RobWilks/Seeed-Soil-Sense/Photos/20260323_125657.jpg

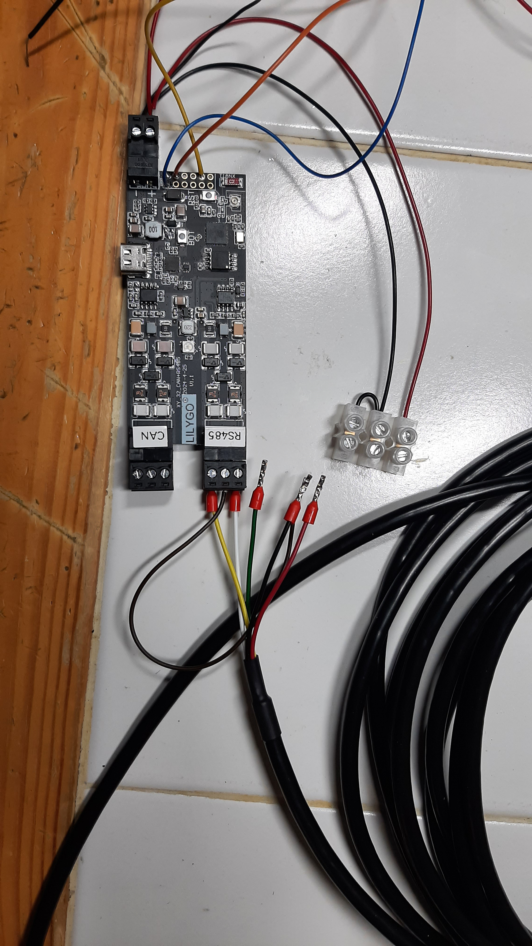
Photos/20260323_125657.jpg
