RobWilks/Seeed-Soil-Sense/Photos/20260323_132616.jpg

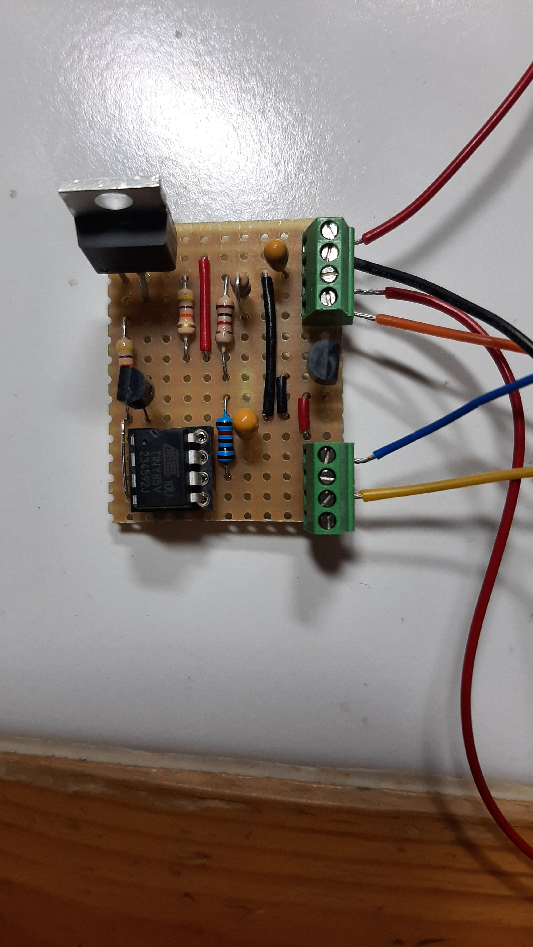
Photos/20260323_132616.jpg
