RobWilks/Seeed-Soil-Sense/Photos/20260323_163038.jpg

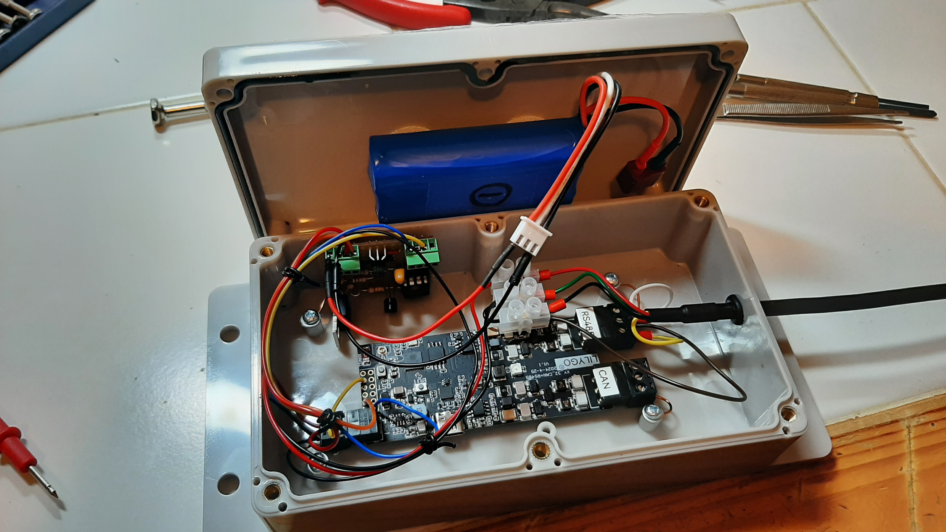
Photos/20260323_163038.jpg
