RobWilks/Seeed-Soil-Sense/TCAN_Soil_Sense_circuit.png

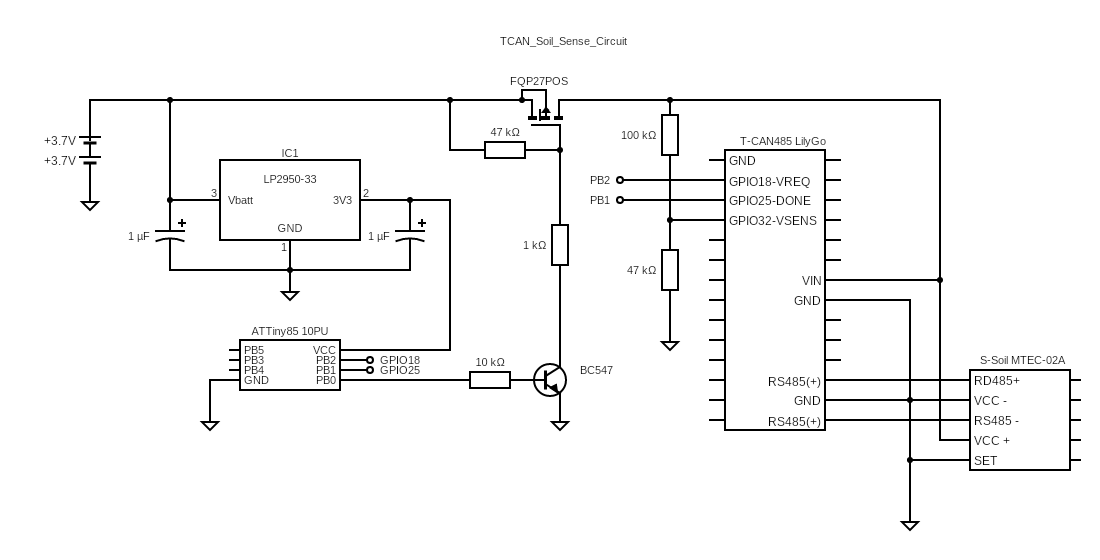
TCAN_Soil_Sense_circuit.png
