RobWilks/Seeed-Soil-Sense/tinyWatchdogVoltageSwitchV3.png

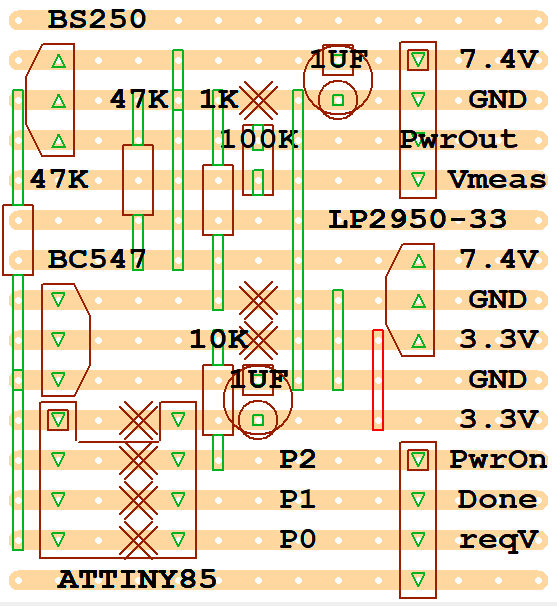
tinyWatchdogVoltageSwitchV3.png
