RobWilks/Seeed-Soil-Sense/SS1 calibration data.xlsx

Sheet: SS1 calibration data
entity_id | last_changed | timeValue | state |  | Cumulative Vol Added | Time | rowIndex | VMC
sensor.soil_sensor_e136_moisture | 2026-03-16 | 46097.00 | 3.36 |  |  | 3/16/2026 19:02:00 | 87
sensor.soil_sensor_e136_moisture | 2026-03-16 00:00 | 46097.00 | 3.39 |  | 0 | 3/17/2026 12:05:00 | 195 | 6.261834862
sensor.soil_sensor_e136_moisture | 2026-03-16 00:01 | 46097.00 | 3.36 |  |  | 3/17/2026 12:07 | 195
sensor.soil_sensor_e136_moisture | 2026-03-16 00:02 | 46097.00 | 3.39 |  | 10 | 3/17/2026 16:00 | 208 | 5.531428571
sensor.soil_sensor_e136_moisture | 2026-03-16 00:03 | 46097.00 | 3.36 |  |  | 3/17/2026 19:00 | 217 | 6.048888889
sensor.soil_sensor_e136_moisture | 2026-03-16 00:04 | 46097.00 | 3.39 |  | 20 | 3/18/2026 06:42 | 341 | 7.122113821
sensor.soil_sensor_e136_moisture | 2026-03-16 00:07 | 46097.01 | 3.36 |  | 32 | 3/19/2026 07:30 | 648 | 10.27413194
sensor.soil_sensor_e136_moisture | 2026-03-16 00:12 | 46097.01 | 3.39 |  | 43 | 3/19/2026 08:48 | 672 | 11.9652
sensor.soil_sensor_e136_moisture | 2026-03-16 00:13 | 46097.01 | 3.36
sensor.soil_sensor_e136_moisture | 2026-03-16 00:55 | 46097.04 | 3.39 |  | 32 | 3/19/2026 07:30 | 781
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
