RobWilks/Seeed-Soil-Sense/esp32SoilSenseDeviceCharacterisation.xlsx

Sheet: currentData.csv
Timestamp(ms) | Current(mA) | startTime | measurementPeriod | onTime
52377 | 12.4 | 24244 | 0
52388 | 13.7 | 24244 | 0 | 0
52400 | 14.5 | 24244 | 0 | 0 | Average on current | 49.33312916
52412 | 22 | 24244 | 0 | 0 | average measurement period | 126.58
52423 | 24.1 | 24244 | 0 | 0 | average on time | 8.16
52435 | 22.6 | 24244 | 0 | 0
52447 | 24.2 | 24244 | 0 | 0
52458 | 24.1 | 24244 | 0 | 0
52470 | 24.3 | 24244 | 0 | 0
52482 | 25.8 | 24244 | 0 | 0
52493 | 24.9 | 24244 | 0 | 0
52505 | 26 | 24244 | 0 | 0
52516 | 25.7 | 24244 | 0 | 0
52529 | 25.9 | 24244 | 0 | 0
52540 | 25.9 | 24244 | 0 | 0
52551 | 25.1 | 24244 | 0 | 0
52563 | 26 | 24244 | 0 | 0
52575 | 24.1 | 24244 | 0 | 0
52586 | 25.9 | 24244 | 0 | 0
52598 | 26 | 24244 | 0 | 0
52610 | 26 | 24244 | 0 | 0
52622 | 25.9 | 24244 | 0 | 0
52633 | 25.4 | 24244 | 0 | 0
52644 | 25.9 | 24244 | 0 | 0
52657 | 24.7 | 24244 | 0 | 0
52668 | 26 | 24244 | 0 | 0
52679 | 25.9 | 24244 | 0 | 0
52691 | 25.7 | 24244 | 0 | 0
52703 | 25.9 | 24244 | 0 | 0
52715 | 24.3 | 24244 | 0 | 0
52726 | 25.9 | 24244 | 0 | 0
52738 | 25.9 | 24244 | 0 | 0
52750 | 25.8 | 24244 | 0 | 0
52761 | 25 | 24244 | 0 | 0
52772 | 22.2 | 24244 | 0 | 0
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
