RobWilks/Seeed-Soil-Sense/(commit log)

2026-03-26 file upload
    [SS1 calibration data.xlsx, esp32SoilSenseDeviceCharacterisation.xlsx]
2026-03-26 Update README with power consumption information
    Added details about current consumption and battery lifetime.
2026-03-26 Update README with more information on soil sensor
    Added additional links and details about the soil sensor integration and power management.
2026-03-26 Refactor README to integrate links
    Updated README to improve clarity and organization of information regarding the soil sensor integration and related components.
