RobWilks/Seeed-Soil-Sense/Photos/20260324_095608.jpg

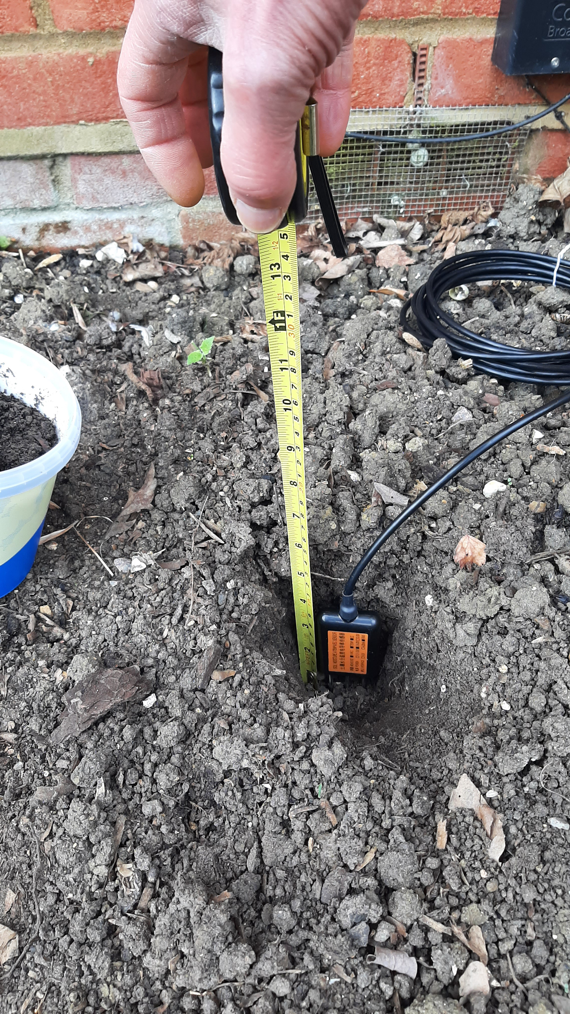
Photos/20260324_095608.jpg
